lokkiikkol/midi-bass-controller/midibass.jpg

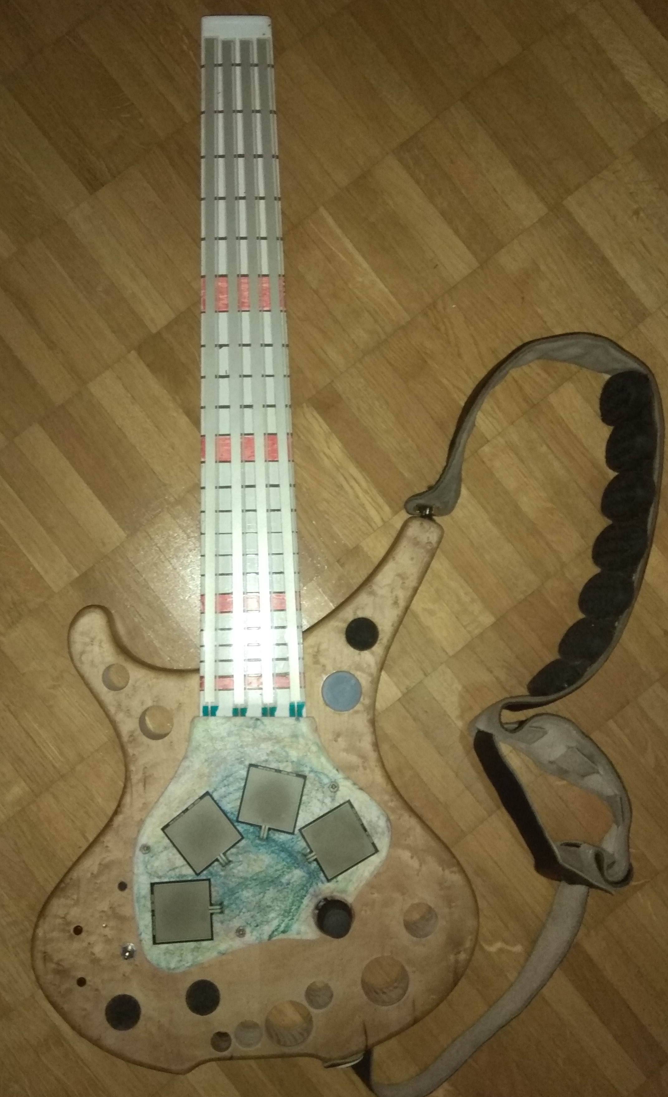
midibass.jpg
