lokkiikkol/midi-bass-controller/(commit log)

2017-11-18 arduino code for the ribbonbasscontroller
    here is the code for my midi bass
2018-05-05 version with 6fsrs
    removed pressure sensor and sustain pedal. added global 5th fsr and foot fsr, to get full legato (i.e. tapping) with aftertouch control.
